oh2mp/esp8266_wattson/images/wattson_board_under.jpg

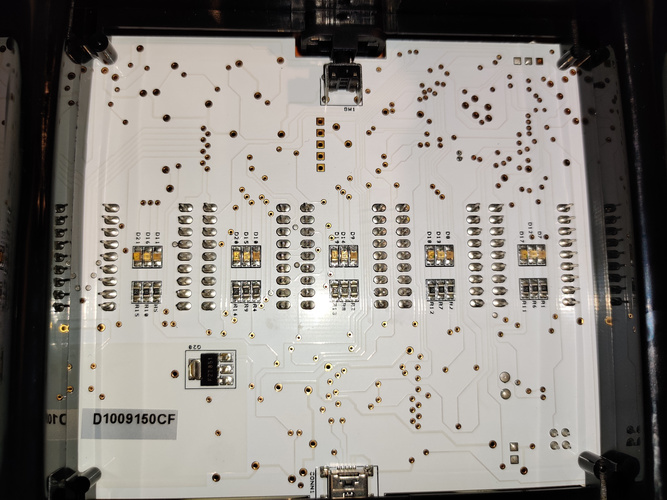
images/wattson_board_under.jpg
